sezyl/Water-Level-Sensor/(threads)

Thread 1 (2019-03-22):

Implement seting threshold

sezyl, 2019-03-22:
Implement sensor calibration method - setting pump on and pump off thresholds.

sezyl, 2019-04-04:
Added the feature #7

Closed 2019-04-04.

Thread 2 (2019-03-22):

Tracking water level during pumping out

sezyl, 2019-03-22:
Currently controller turns off pump few seconds after achieving low threshold level. It would be much safer if water level is tracked during pumping out to ensure that it is lowering.

This would help with opening bottom end of the sensor pipe allowing fresh air comming into it.

Suggested solution: as soon as low threshold is achieved continue pumping out as long as water level is droping.

sezyl, 2019-04-03:
Feature added. #5

Closed 2019-04-03.

Thread 6 (2019-04-04):

Wrong temperature sensor reading

sezyl, 2019-04-04:
Internal sensor reading is incorrect.

sezyl, 2019-04-04:
Fixed.

Closed 2019-04-04.

Thread 8 (2019-04-08):

overflow at sensor percentage calculation

sezyl, 2019-04-08:
sensorPercentage calculation in loop() (line 90) could overflow at multiplication by 100. This might result in too long delay at line 97 which in effect result in too slow reporting water level.

Closed 2019-04-08.
