sezyl/Water-Level-Sensor/(commit log)

2019-03-19 Create PressureSensor.ino
    Initial release of Arduino sketch
2019-03-20 adding Arduino installation script
2019-04-03 Tracking water level after passing low threshold (#5)
    * Added tracking water level
    When water achieves low threshold level pump is still on as long as water level is lowering but not longer than defined timeout.
    * organizing sources to avoid compilation problems
    Arduino has its own method of mergin files.
    [config.ino, d_controller.ino, d_sensor.ino, e_main.ino, x_test.ino]
2019-04-04 Corrected internal temperature sensor reading
    * fixed bug with reading
    * changed timeouts for pumping
    * cleaned code a little
    [config.ino, d_sensor.ino, e_main.ino]
2019-04-04 Added calibration routine (#7)
    Pulling PB3 low during start-up enters into calibration mode.
2019-04-08 Bug with sensor percentage calculation fixed
    * fixing bug with sensor percentage calculation
    * cleaning code
    * removing dead code
    [config.ino, d_controller.ino, d_sensor.ino, e_main.ino]
2019-04-12 fixing wrong level percentage indicator
    fixing bug #9
    [e_main.ino]
