sezyl/Water-Level-Sensor/(notices)

Notices in the files:
README.md:
License: MIT
